probstj03/ARC-Slate/firmware/src/slate/assets/bootscreen_original.png

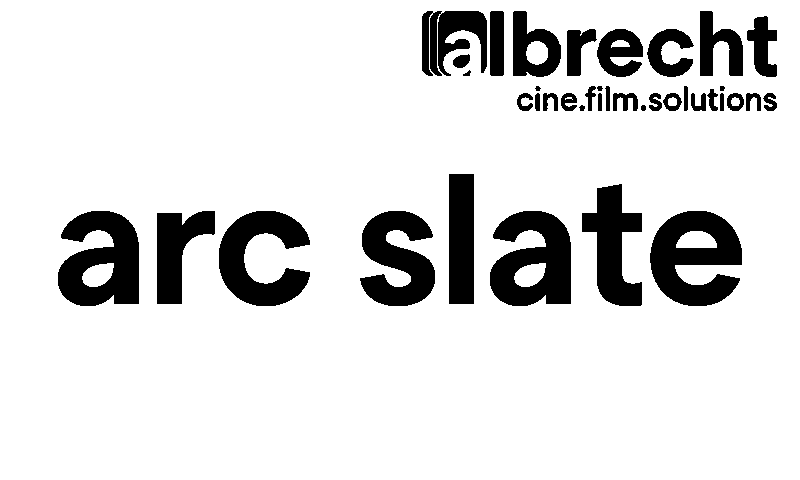
firmware/src/slate/assets/bootscreen_original.png
