probstj03/ARC-Slate/hardware/AS1.1/AS1.1.png

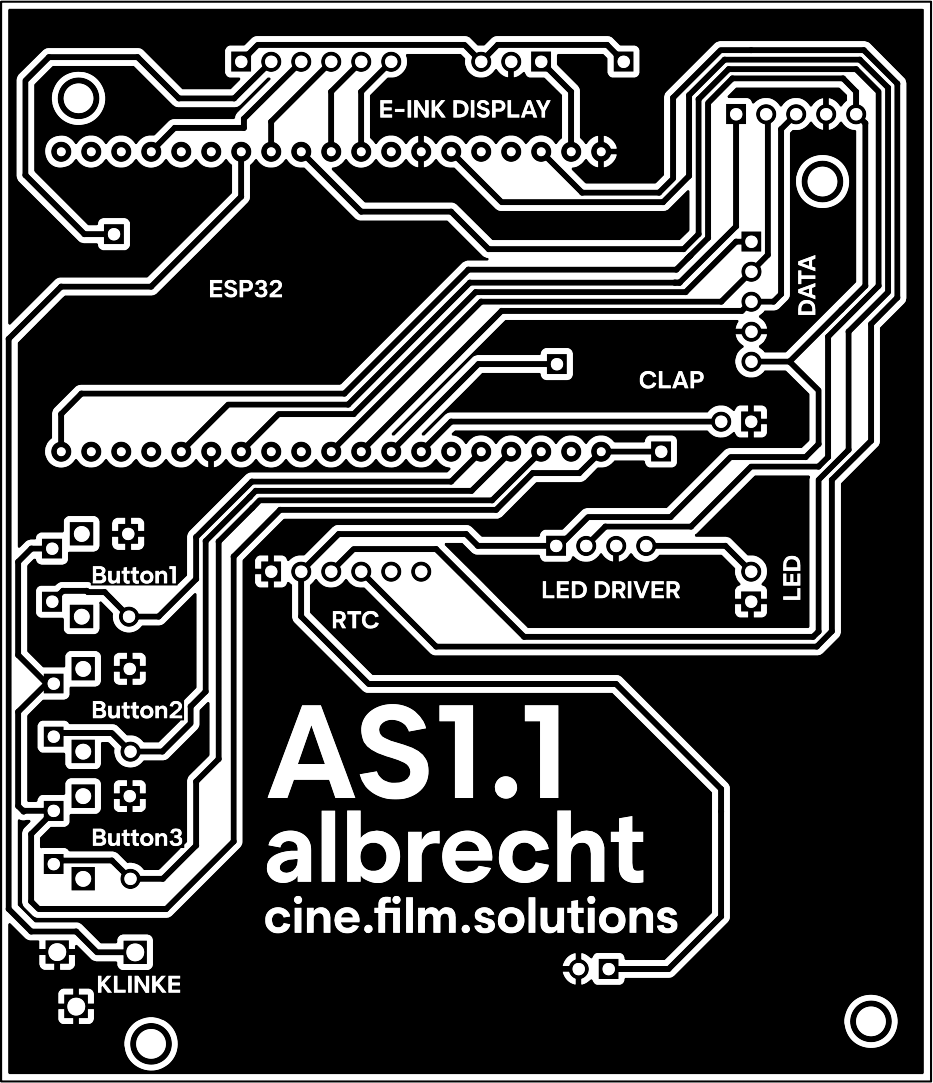
hardware/AS1.1/AS1.1.png
