probstj03/ARC-Slate/hardware/3D-Objekte/Batteriefach.FCStd

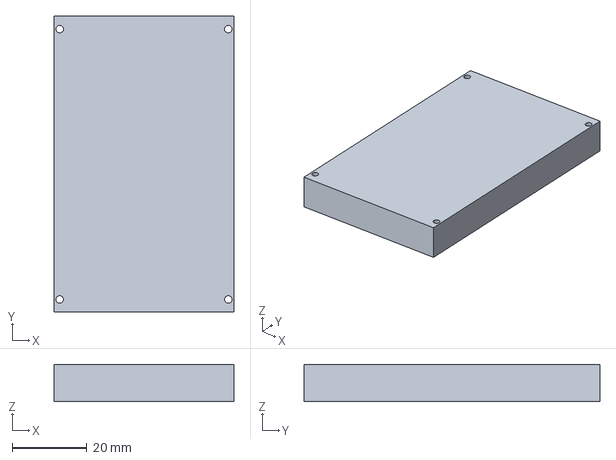
[picture p3: CAD file, 2026-10-11]
hardware/3D-Objekte/Batteriefach.FCStd
48.0 x 79.0 x 10.0 mm
