probstj03/ARC-Slate/hardware/3D-Objekte/Display_Schutzplatte.stl

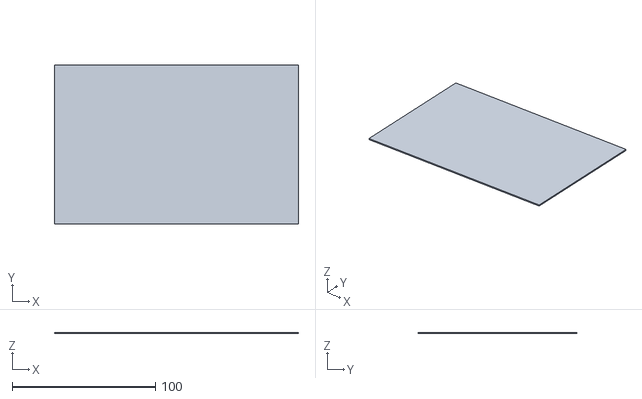
[picture p4: CAD file, 2026-10-11]
hardware/3D-Objekte/Display_Schutzplatte.stl
170.2 x 111.2 x 1.00
