probstj03/ARC-Slate/hardware/3D-Objekte/7x1 Matrix Halterung.stl

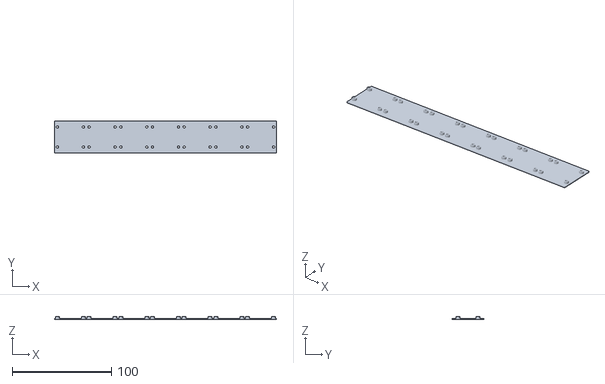
[picture p5: CAD file, 2026-10-11]
hardware/3D-Objekte/7x1 Matrix Halterung.stl
224.0 x 32.0 x 3.00
