probstj03/ARC-Slate/hardware/3D-Objekte/7x1 Matrix Halterung_V2.FCStd

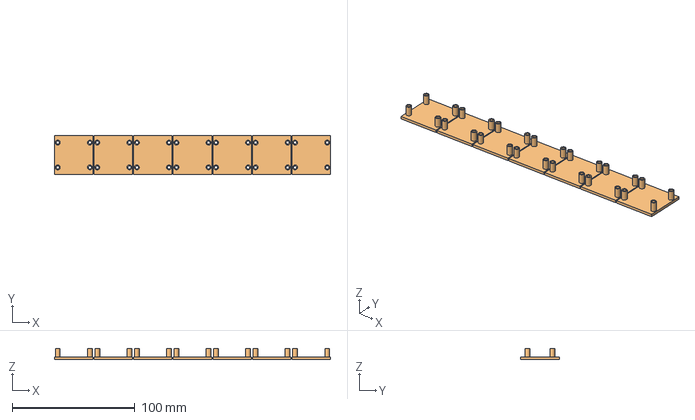
[picture p6: CAD file, 2026-10-11]
hardware/3D-Objekte/7x1 Matrix Halterung_V2.FCStd
225.3 x 31.5 x 9.00 mm
Matrix
