probstj03/ARC-Slate/hardware/3D-Objekte/3x3 Matrix Halterung.FCStd

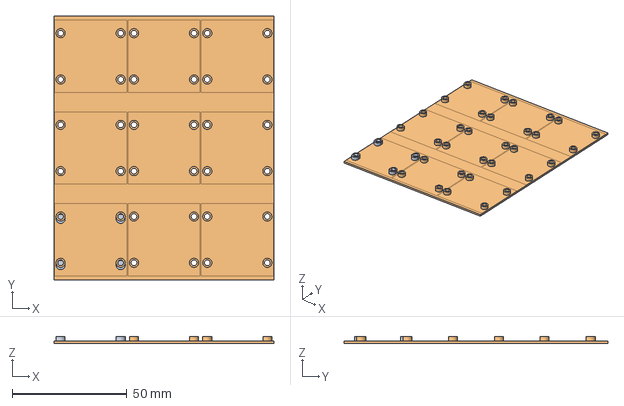
[picture p8: CAD file, 2026-10-11]
hardware/3D-Objekte/3x3 Matrix Halterung.FCStd
96.0 x 115.0 x 3.00 mm
Matrix
