probstj03/ARC-Slate/hardware/3D-Objekte/Display Halterung.FCStd

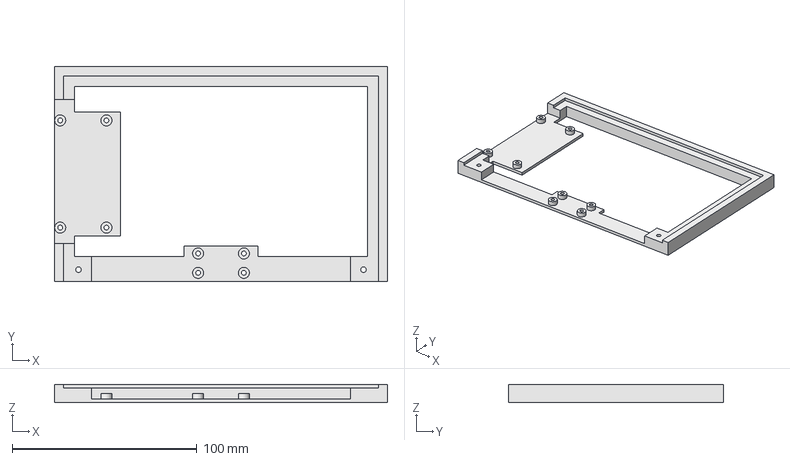
[picture p9: CAD file, 2026-10-11]
hardware/3D-Objekte/Display Halterung.FCStd
180.2 x 116.2 x 10.0 mm
