probstj03/ARC-Slate/hardware/3D-Objekte/clap_housing_top_V1.stl

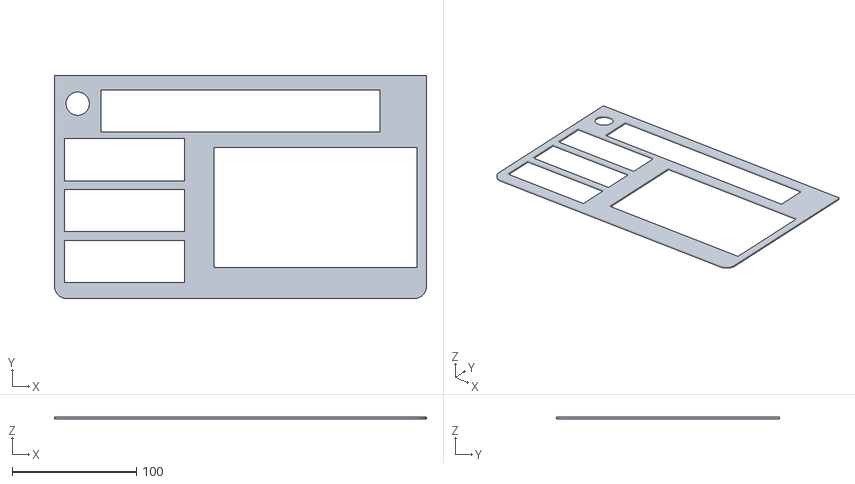
[picture p10: CAD file, 2026-10-11]
hardware/3D-Objekte/clap_housing_top_V1.stl
300.0 x 180.0 x 2.00
