probstj03/ARC-Slate/hardware/3D-Objekte/clap_housing_V1.stl

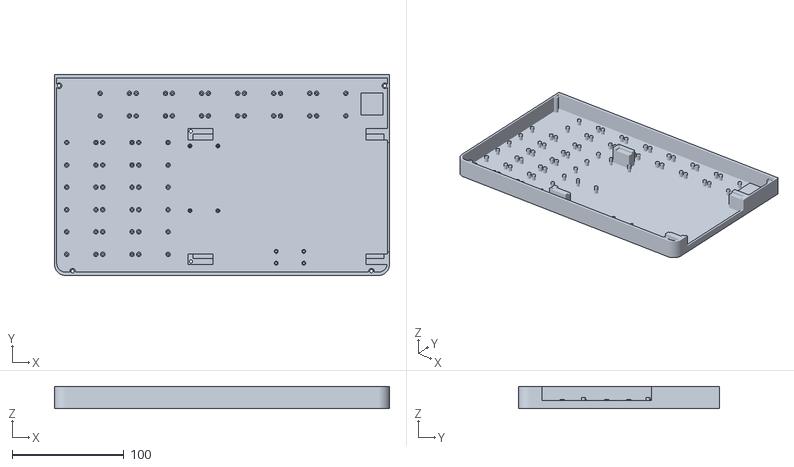
[picture p11: CAD file, 2026-10-11]
hardware/3D-Objekte/clap_housing_V1.stl
300.0 x 180.0 x 20.0
