probstj03/ARC-Slate/hardware/3D-Objekte/Batteriegehäusedeckel.stl

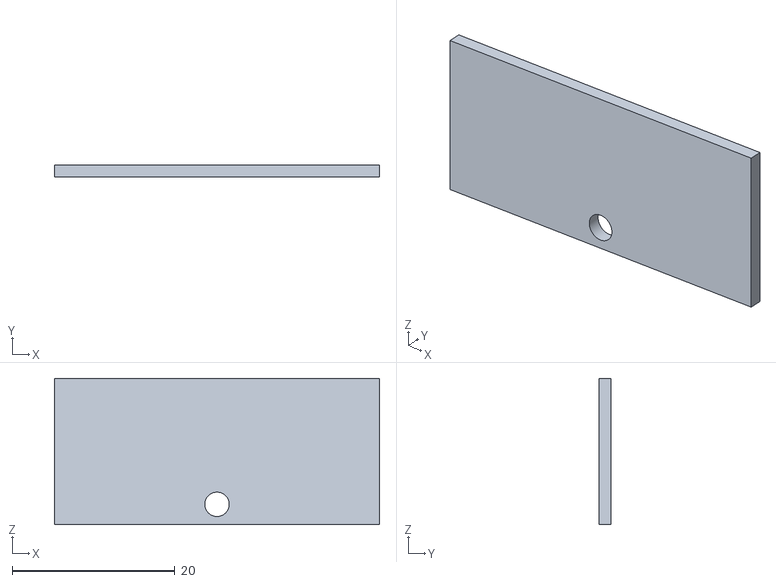
[picture p12: CAD file, 2026-10-11]
hardware/3D-Objekte/Batteriegehäusedeckel.stl
40.0 x 1.50 x 18.0
