probstj03/ARC-Slate/hardware/3D-Objekte/Klappe Gehäuse Deckel V2.stl

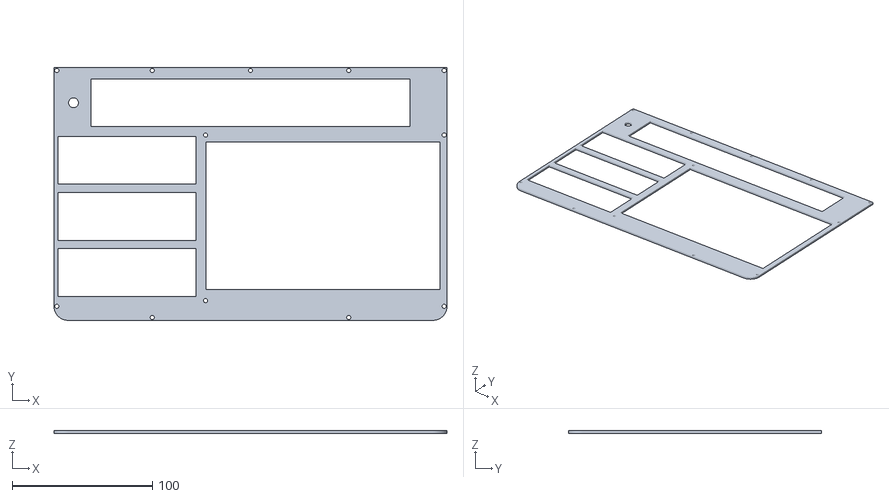
[picture p13: CAD file, 2026-10-11]
hardware/3D-Objekte/Klappe Gehäuse Deckel V2.stl
280.0 x 180.0 x 2.00
