probstj03/ARC-Slate/hardware/3D-Objekte/Matrix Halterung.FCStd

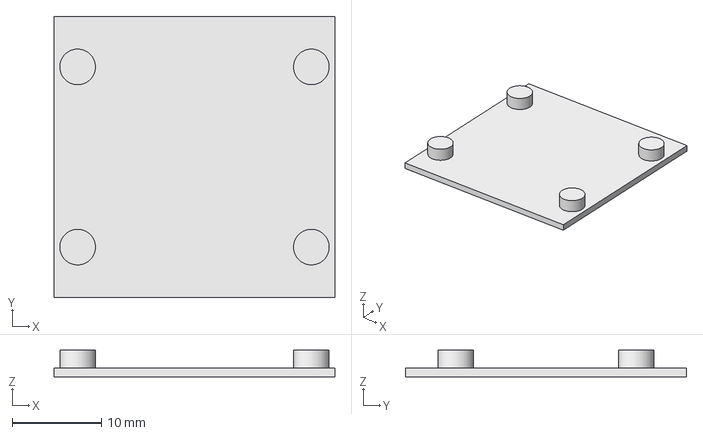
[picture p14: CAD file, 2026-10-11]
hardware/3D-Objekte/Matrix Halterung.FCStd
31.5 x 31.5 x 3.00 mm
