probstj03/ARC-Slate/hardware/3D-Objekte/Klappe Gehäuse V2.FCStd

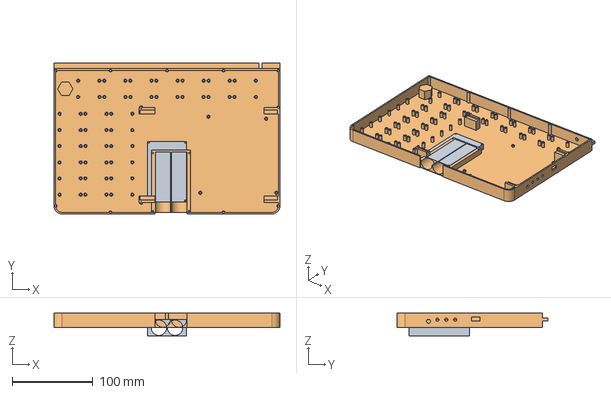
[picture p15: CAD file, 2026-10-11]
hardware/3D-Objekte/Klappe Gehäuse V2.FCStd
280.0 x 187.0 x 28.0 mm
Körper
Gehäuse
