probstj03/ARC-Slate/hardware/3D-Objekte/Batteriegehäusedecke_V2.FCStd

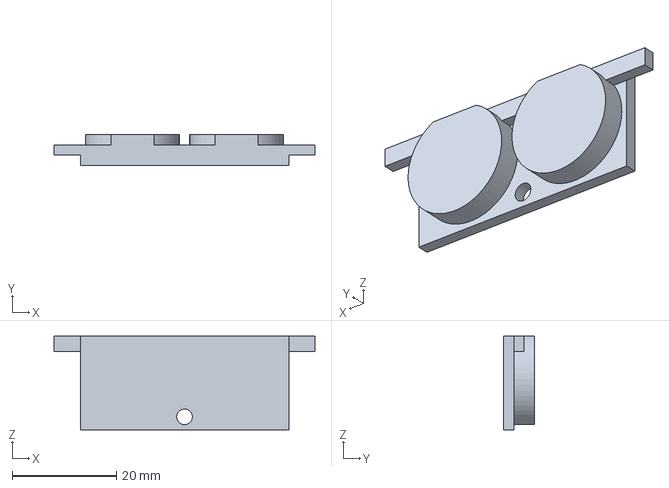
[picture p16: CAD file, 2026-10-11]
hardware/3D-Objekte/Batteriegehäusedecke_V2.FCStd
50.0 x 6.00 x 18.0 mm
