probstj03/ARC-Slate/(list of files, cad)

Other CAD files:
hardware/3D-Objekte/Batteriefach_V1.stl
hardware/3D-Objekte/Klappe Gehäuse V1.FCStd
hardware/3D-Objekte/7x1 Matrix Halterung_V1.FCStd
hardware/3D-Objekte/Klappe Gehäuse V0.1.FCStd
hardware/3D-Objekte/3x3 Matrix Halterung.stl
hardware/3D-Objekte/Batteriegehäusedecke_V2.stl
hardware/3D-Objekte/Display Halterung.stl
hardware/3D-Objekte/Klappe Gehäuse V2.stl
hardware/3D-Objekte/Klappe Gehäusedeckel V2.stl
hardware/3D-Objekte/Matrix Halterung.stl
hardware/3D-Objekte/Matrix_Halterung.stl
