probstj03/ARC-Slate/hardware/AS1.1/AS1.1.kicad_pcb

## KiCad design hardware/AS1.1/AS1.1.kicad_pcb (2026-10-11)

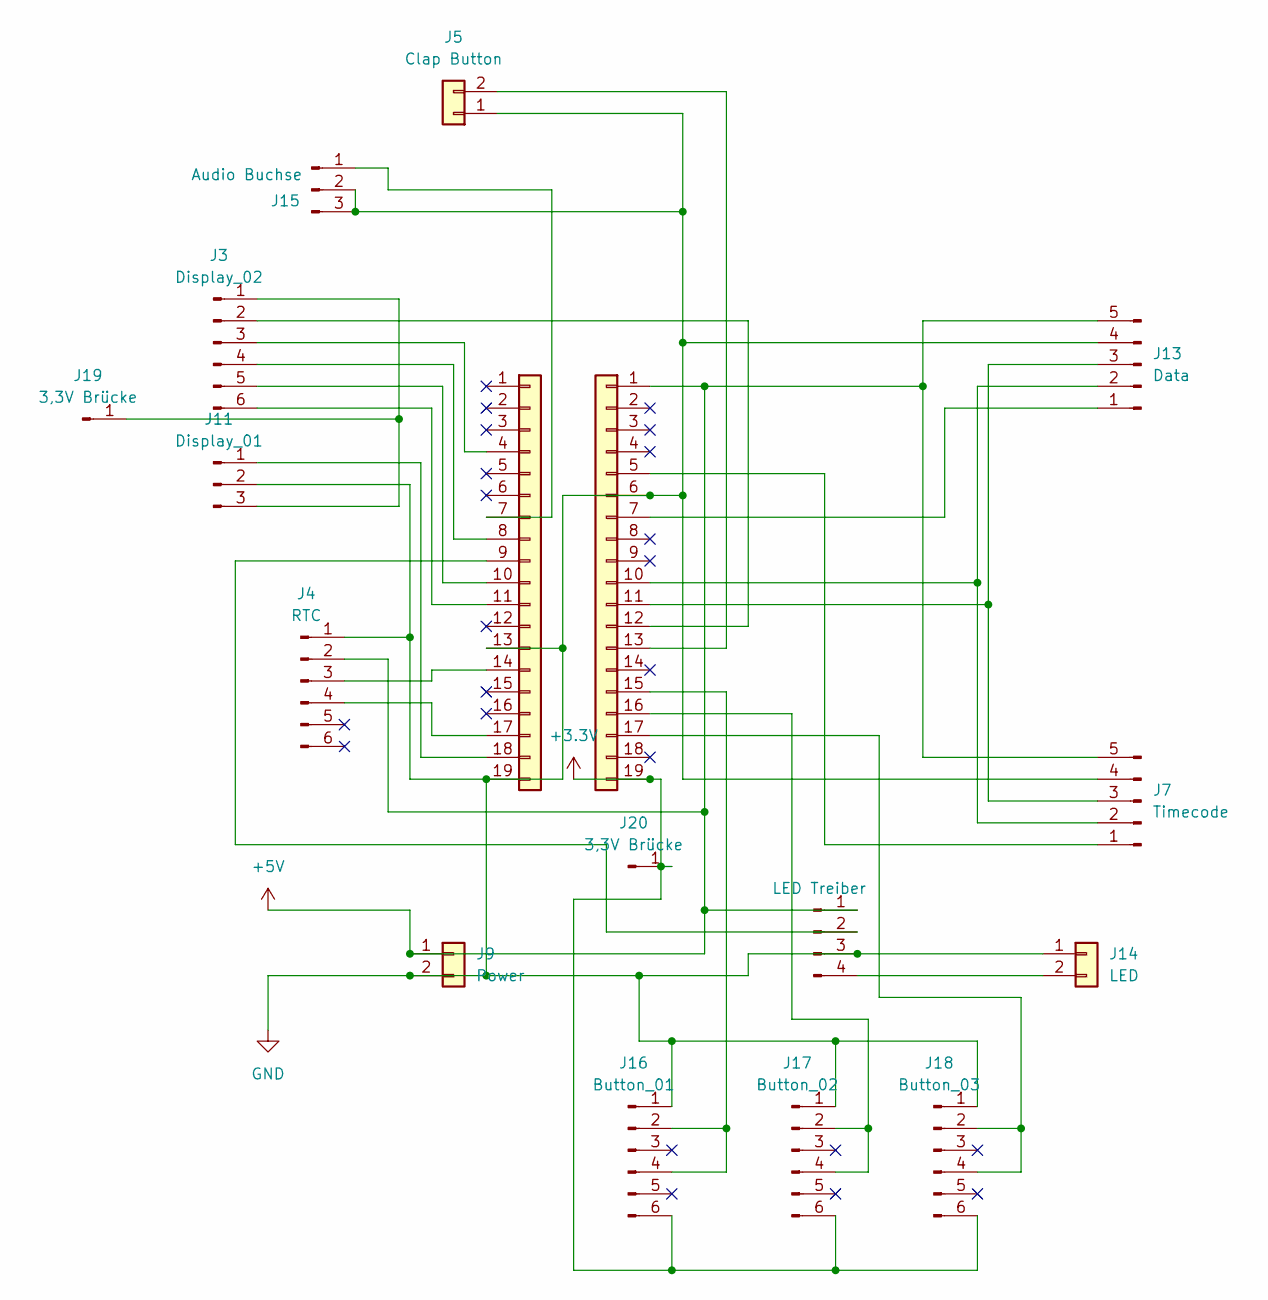
[picture p17: schematic AS1.1.kicad_sch]

Parts:
J3: Display_02; PinSocket_1x06_P2.54mm_Vertical
J4: RTC; PinSocket_1x06_P2.54mm_Vertical
J5: Clap Button; PinSocket_1x02_P2.54mm_Vertical
J7: Timecode; PinSocket_1x05_P2.54mm_Vertical
J8: LED Treiber; PinSocket_1x04_P2.54mm_Vertical
J9: Power; PinSocket_1x02_P2.54mm_Vertical
J10, J12: Conn_01x19; PinSocket_1x19_P2.54mm_Vertical
J11: Display_01; PinSocket_1x03_P2.54mm_Vertical
J13: Data; PinSocket_1x05_P2.54mm_Vertical
J14: LED; PinSocket_1x02_P2.54mm_Vertical
J15: Audio Buchse; PinSocket_1x03_P2.54mm_Vertical
J16: Button_01; Taster_90Grad
J17: Button_02; Taster_90Grad
J18: Button_03; Taster_90Grad
J19, J20: 3,3V Brücke; PinSocket_1x01_P2.54mm_Vertical

Connections:
+3.3V: J12.19, J16.6, J17.6, J18.6, J20.1
+5V: J4.2, J7.5, J8.1, J9.1, J12.1, J13.5
GND: J4.1, J5.1, J7.4, J8.3, J9.2, J10.13, J10.19, J11.2, J12.6, J13.4, J14.1, J15.2, J15.3, J16.1, J17.1, J18.1
unnamed: J3.3, J10.4
unnamed: J10.7, J15.1
unnamed: J3.4, J10.8
unnamed: J8.2, J10.9
unnamed: J3.5, J10.10
unnamed: J3.6, J10.11
unnamed: J4.3, J10.14
unnamed: J4.4, J10.17
unnamed: J10.18, J11.1
unnamed: J3.1, J11.3, J19.1
unnamed: J7.1, J12.5
unnamed: J12.7, J13.1
unnamed: J7.2, J12.10, J13.2
unnamed: J7.3, J12.11, J13.3
unnamed: J5.2, J12.13
unnamed: J12.15, J16.2, J16.4
unnamed: J12.16, J17.2, J17.4
unnamed: J12.17, J18.2, J18.4
unnamed: J8.4, J14.2

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
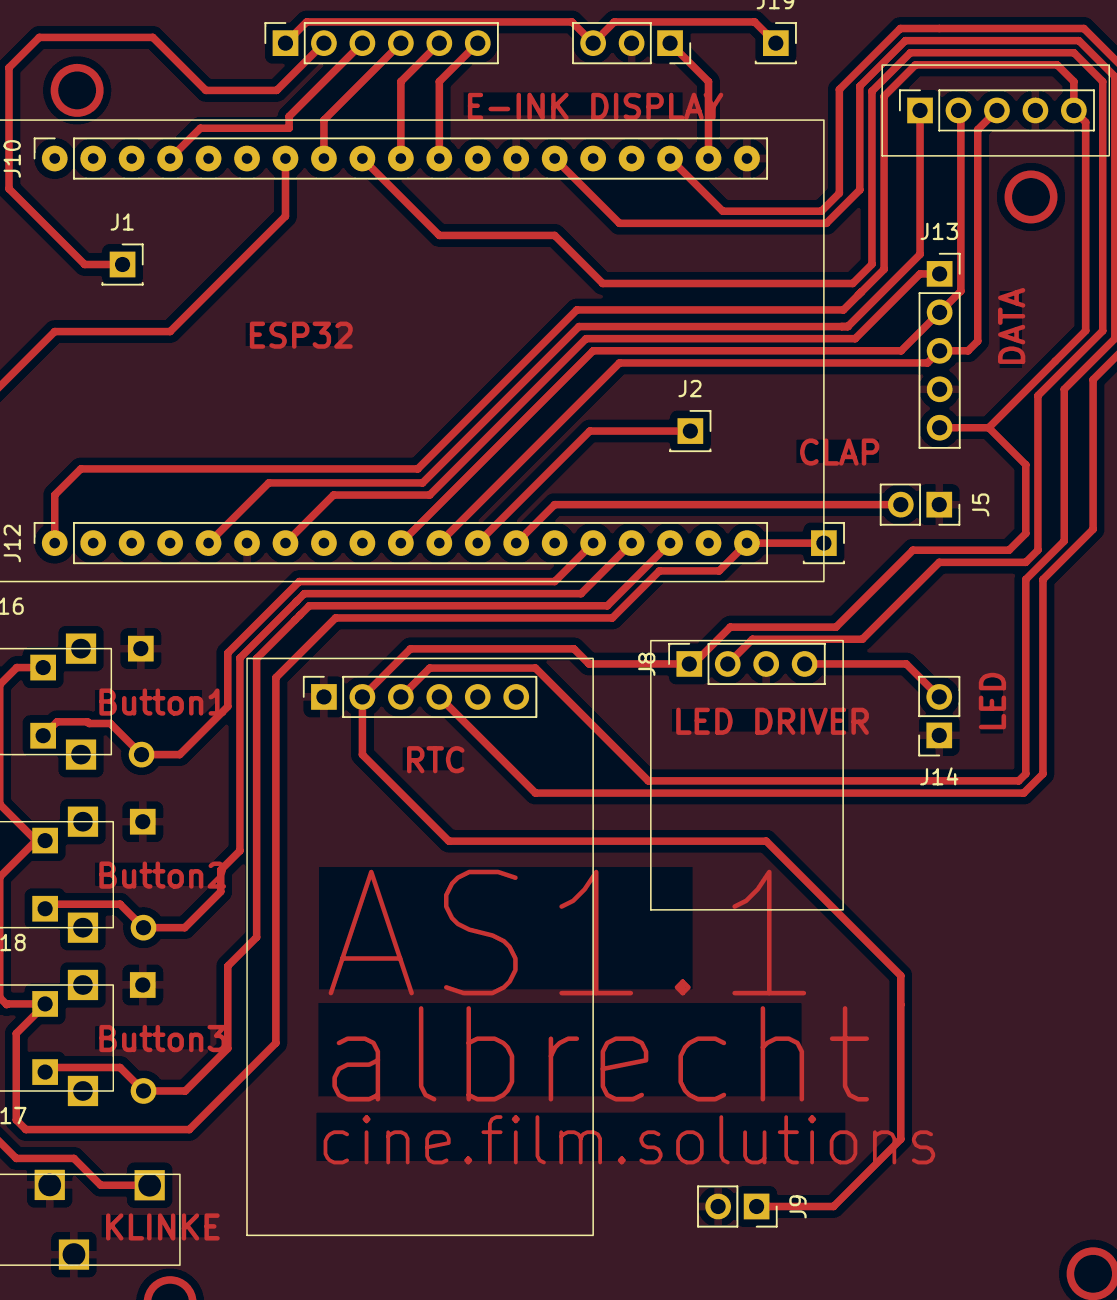
[picture p18: board AS1.1.kicad_pcb from above]

Board: 2 copper layers, 19 parts (0 on the bottom side), 24 nets.

Other parts of the board:
J1, J2: PIN Brücke; PinSocket_1x01_P2.54mm_Vertical
