probstj03/ARC-Slate/(commit log)

2026-10-11 Initialer Import von ARC-Slate
    [3x3 Matrix Halterung.FCStd, 3x3 Matrix Halterung.stl, 7x1 Matrix Halterung.stl, 7x1 Matrix Halterung_V1.FCStd, 7x1 Matrix Halterung_V2.FCStd, AS1.1.kicad_pcb, AS1.1.kicad_sch, Batteriefach.FCStd]
2026-10-11 Verdrahtung für ARC_AP-Platine, Bauteilliste, README, Aufräumen
    - hardware/wiring/ARC-Slate_Verdrahtung.svg: Belegung U4/J1/SW1, Strompfad, Hinweise
    - components.txt auf ARC_AP mit Drehencoder umgestellt
    - software_old entfernt (READ ARC liegt jetzt in ARC-Server/server/readarc)
    - KiCad-Backups, Lock-Datei, Mac-Konfigurationen und Duplikate aus dem Repo genommen
    [results.csv]
2026-10-11 Firmware 2.0.0-dev für die ARC_AP-Platine
    - modular: arc_clock, ltc_engine, matrix, epaper, ui, clap, net, state
    - RTC-disziplinierte µs-Uhr, SQW-Flanke wird automatisch gemessen
    - Free Run framegenau an der RTC, Jam Sync stellt die RTC per Frame-Zeitstempel,
    Jam Rec läuft nach dem Lock weiter, TC-Ausgang bleibt bis 'Kabel ab' stumm
    - beide MAX7219-Ketten (7 + 9 Module) über Hardware-SPI, kein LedControl-Limit
    - E-Ink mit QR-Code (ARC2-Format), Menü und Statuszeile per Teil-Aktualisierung
    - Drehencoder-Bedienung mit Menü
    - Klappe: Blitz aus der ISR, Ereignis mit RTC-µs + TC + Subframe, Log im Flash
    - bekannte WLANs im NVS (secrets.h nur lokal), Rückfall ARC-Net, mDNS arc-slate
    - Pl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
    [clap.cpp, clap.h, epaper.cpp, epaper.h, main.cpp]
2026-10-11 Slate-Firmware auf ARC-Core umgestellt
    - Uhr, LTC-Generator/-Decoder, Jam Sync, Netzwerk und Ereignis-Log kommen aus ARC-Core
    - Generator jetzt phasengeregelt (Sample-Slipping), Latenz per Loopback kalibriert
    - Jam Sync mit 30-s-Prüfphase und DS3231-Aging-Abgleich
    - slate_link: Slate-spezifisches Protokoll (Shot, Slate-Zustand, Userbits)
    - audio-tools nicht mehr nötig
    [clap.cpp, epaper.cpp, main.cpp, matrix.cpp, matrix.h, slate_link.cpp, slate_link.h]
2026-10-11 README: Jam-Prüfphase in der Inbetriebnahme
2026-10-12 Offline-Projekte: Shotliste auf den Geräten, Logs nachträglich abholen
    - ARC-Core: arc_project (project_put -> /project.json, log_pull/log_chunk/log_ack),
    hello meldet projectCode und lastEventId
    - Geräte: Shot-Auswahl ohne ARC-Studio aus dem Offline-Projekt, Take-Nummer aus dem eigenen Log
    - ARC-Studio: 'Projekt auf Geräte', automatisches Abholen und Einsortieren offline aufgezeichneter
    Ereignisse (Duplikaterkennung, Stand je Gerät in deviceLogs); Geräte verbinden erst nach dem Laden des Projekts
2026-10-12 Doppel-Boot: ARC-Slate (ota_0) und ARC-Clock (ota_1) auf einem ESP
    - Quellcode aufgeteilt in src/common (Pins, SPI, App-Wechsel), src/slate, src/clock.
    - Zwei PlatformIO-Umgebungen (slate, clock); N16R8-Einstellungen (16 MB Flash,
    Octal-PSRAM) und neue Partitionstabelle partitions_16mb_dual.csv
    (zwei Apps je 4 MB, gemeinsames NVS und LittleFS).
    - bootsel: App-Wechsel per esp_ota_set_boot_partition mit Pruefung des Images;
    Slate-Menue 'Uhr-Modus', seriell 'mode clock', Encoder-Knopf beim Einschalten halten.
    - Clock-Upload schreibt nur die App an 0x410000 (Bootloader, Partitionen und
    Boot-Auswahl bleiben unberuehrt).
    - ARC-Clock vorerst nur als Geruest (kann zurueck zur Slate wechseln)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
    [partitions_16mb_dual.csv]
2026-10-12 Matrix- und E-Ink-Treiber nach src/common, Slate-Renderer getrennt
    - common/matrix: Treiber + Anzeige-Task mit Renderer-Hook, setEnabled() (MAX7219-Shutdown),
    Zeichenhilfen (renderText, place, field). Slate-Inhalte jetzt in slate/matrix_slate.
    - common/epd_driver: Display-Objekt, SPI-Freigabe waehrend BUSY, Text-Helfer.
    - Slate-Verhalten unveraendert.
2026-10-12 ARC-Clock: reine Kernmodule mit Host-Tests (Datum/Zeitzone, iCal/CalDAV, Obsidian-To-Do, Wetter, Mond, Agenda)
    - civil: Datum ohne libc-Zeitzonen, Europe/Berlin mit EU-Sommerzeitregel, ISO-Woche, deutsche Namen.
    - fold: UTF-8 -> ASCII fuer die GFX-Fonts (Umlaute, Anfuehrungszeichen, Emoji entfernt).
    - ics: Streaming-Parser fuer iCalendar und CalDAV-Multistatus (beliebige Chunks, gefaltete Zeilen,
    XML-Entities, VALARM/VTIMEZONE ignoriert, abgesagte Termine uebersprungen).
    - todo: Obsidian-Markdown (Tasks-Plugin-Emojis, Dataview-Felder, Abschnittsfilter) + Sortierung.
    - weather: Open-Meteo-Parser (ArduinoJson-Filter), WMO-Code -> Icon-Art.
    - moon: Mondphase aus dem synodischen Monat. agenda: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
2026-10-12 ARC-Clock: Firmware fuer Matrizen und E-Ink, Daten aus Nextcloud und Open-Meteo
    - clock_config: Einstellungen im NVS (Nextcloud, Kalender, To-Do, Ort, Zeiten), Vorbelegung ueber secrets.h.
    - http_client + ca_roots: HTTPS mit kuratierten Wurzelzertifikaten (tools/gen_ca_roots.py), eigene CA ueber /ca.pem.
    - data_store: Hintergrund-Task fuer CalDAV-REPORT (Server expandiert Wiederholungen), WebDAV-GET mit ETag
    (Obsidian-md), Open-Meteo; Cache auf LittleFS, Backoff, nur mit echtem WLAN.
    - matrix_clock: HH:MM:SS mit Sekundenbalken, Wetter-Animation links, Info-Seiten Mitte/rechts
    (Temperatur, gefuehlt, Regen, Wind / Mond, naechster Termin, Datum, Sonnenauf-/-untergang),
    Termin-Erinnerung a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
2026-10-12 ARC-Clock: E-Ink-Layout als eigenes Modul mit Host-Vorschau (PNG), Layout-Korrekturen
    - layout/epd_layout: Zeichencode nur noch gegen Adafruit_GFX; epd_clock.cpp steuert nur noch Plan und Daten.
    - core/data_model.h: Datenmodell ohne Arduino (von Speicher, Matrix und Layout gemeinsam genutzt).
    - test_host/render_epd.cpp + stubs: rendert das echte Layout mit der echten Adafruit_GFX in ein Bitmap
    (py test_host/run.py --preview -> test_host/out/epd_preview*.png), drei Varianten: Normalfall, Fehler/offline, Schnee.
    - Korrekturen aus der Vorschau: Text am Rand wurde umgebrochen (setTextWrap(false), Mondblock neu angeordnet),
    Wetterband ueberlappte die Terminleiste, Kalendertitel stiessen an di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
2026-10-15 E-Ink-Inbetriebnahme: neues Logo, Englisch, Matrix-Pause beim Refresh, Debug-Befehle, Helligkeit 1
    - Logo/Startbild aus ARC-Server (tools/gen_logo.py); Parser-Fehler (Kommentar '800x480px' als Datenbyte) behoben.
    - Alle Anzeigetexte auf Englisch (Slate-Menue, Overlays, Statuszeile, Uhr).
    - Matrizen werden vor jedem vollen E-Ink-Refresh abgeschaltet (epddrv::MatrixPause).
    - E-Ink: 2 MHz SPI, laengerer Reset, CS frueh auf HIGH, erstes Bild erst nach dem WLAN-Start,
    Teil-Refresh standardmaessig aus.
    - Debug: epdtest, epdpins, epdlab, epdspi, epdpartial.
    - Standard-Helligkeit 1 (Slate und Uhr), neue NVS-Schluessel.
    - README: Erfahrungen zur Stromversorgung.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
    [agenda.cpp, agenda.h, civil.cpp, civil.h, clock_config.cpp, clock_config.h, epaper.cpp]
2026-10-15 E-Ink: Refresh mit Booster-Ueberwachung, kurze Matrix-Pause, Teil-Refresh wieder an
    - epd_driver: refreshFull()/refreshWindow() fuer Slate und Uhr. Matrizen nur waehrend des Booster-Starts
    (~0,3 s) aus (epdpause 0|1|2: aus / Booster-Start / ganzer Refresh).
    - Erkennung des Booster-Fehlers (PowerOn ~2,04 s ohne Update): Panel in Tiefschlaf, weitere Refreshes ausgesetzt,
    damit das gezeigte Bild nicht verwaescht (epdresume oder Neustart gibt wieder frei).
    - Teil-Refresh fuer Menue und Statuszeile wieder standardmaessig an.
    - Experiment epdrecover SEC [wifioff]: Tiefschlaf + optional WLAN aus; im Test loeste das den Fehler nicht,
    der Booster braucht eine staerkere 3,3-V-Versorgung am Panel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
2026-10-19 E-Ink: keine Matrix-Pause, Reset vor jedem Voll-Refresh, schwache SPI-Treiber; Menue auf den Matrizen; Uhr: Sekundenbalken weg, E-Ink nach Start und nur bei Erfolg als erledigt
    [epaper.cpp, epaper.h, epd_clock.cpp, epd_driver.cpp, epd_driver.h, main.cpp, matrix.cpp, matrix.h]
2026-10-19 ARC-Clock: Matrix nur Aktuelles (Uhrzeit, Temperatur, Wetter-Animation ueber alle Module, Termin-Laufschrift mit Blitz), E-Ink nur bei Aenderungen (Pruefung alle 15 min), Lato-Schrift mit Umlauten, L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
2026-10-19 ARC-Clock: Symbole aus Weather Icons (OFL), Sekunden zurueck mit Trennlinie vor der Temperatur
2026-10-19 ARC-Clock: gezeichnete E-Ink-Symbole zurueck, Uhrzeit mittig, Wetter-Animation ueber alle 9 Module mit Temperatur (Gradzeichen) in der Szene, groessere Sonne/Wolken, sichtbarer Regen; Vorschau test_h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
2026-10-19 ARC-Clock: Wetter-Icons 24x16 (animiert, inkl. Nacht bewoelkt) in den oberen zwei Matrix-Reihen, Temperatur mit Grad C in der unteren Reihe, Laufschrift ueber die Uhrzeit-Kette
2026-10-19 ARC-Clock: Wetter-Icons v2 (Luecke zwischen den Reihen), Nacht bewoelkt neu, Animation 400 ms, Sonne ruhig; Kalender: Konto-/Home-Adresse findet die Kalender per PROPFIND
2026-10-19 ARC-Clock: heiter = stehende Sonne mittig oben, Wolken unten (nachts Mond und Sterne oben)
2026-10-19 ARC-Clock: Nextcloud-Anmeldename (nc login, z. B. E-Mail) getrennt von der Benutzer-ID fuer die Pfade
2026-10-20 ARC-Clock: Dashboard ohne more, E-Ink-Mond invertiert (schwarz = Schatten), Kalender mit Tag/Nacht-Streifen, E-Ink-Nachtruhe, echte Mondphase auch auf der Matrix (Sterne statisch, wachsen langsam zum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
2026-10-20 ARC-Clock E-Ink: Termine invertiert, Raster 8-18 Uhr, Abend-Termine erst ab 17 Uhr im Streifen, kleinere Ueberschriften und Listen, Wetterband ohne Linie und buendig, Zeitspanne ueber dem Termin, Das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
2026-10-20 ARC-Clock E-Ink: Teil-Aktualisierung bei kleinen Aenderungen (Zonen Kopf/Wetter/Kalender/Dashboard, voll beim Start, taeglich, bei grossen Aenderungen und nach 12 Teilen), Test epdpart, Vorschau mit 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
2026-10-20 ARC-Clock E-Ink: Wetter wird bei Aenderungen mitgezeichnet (Teil-Refresh der Wetterzone, Regen in 10er-Schritten), Teil-Refresh auch bei offener Klappe, Start-Refresh wartet auf das Netz, Cache erst 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
2026-10-20 ARC-Clock: Teil-Refresh Zone fuer Zone (weit auseinanderliegende Aenderungen werden nicht mehr zu einem vollen Refresh, der bei offener Klappe wartet), Cache wird nach der ersten vollstaendigen Abruf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
